TheMahaanOne/inflatable-wing-uav/docs/flowchart.png

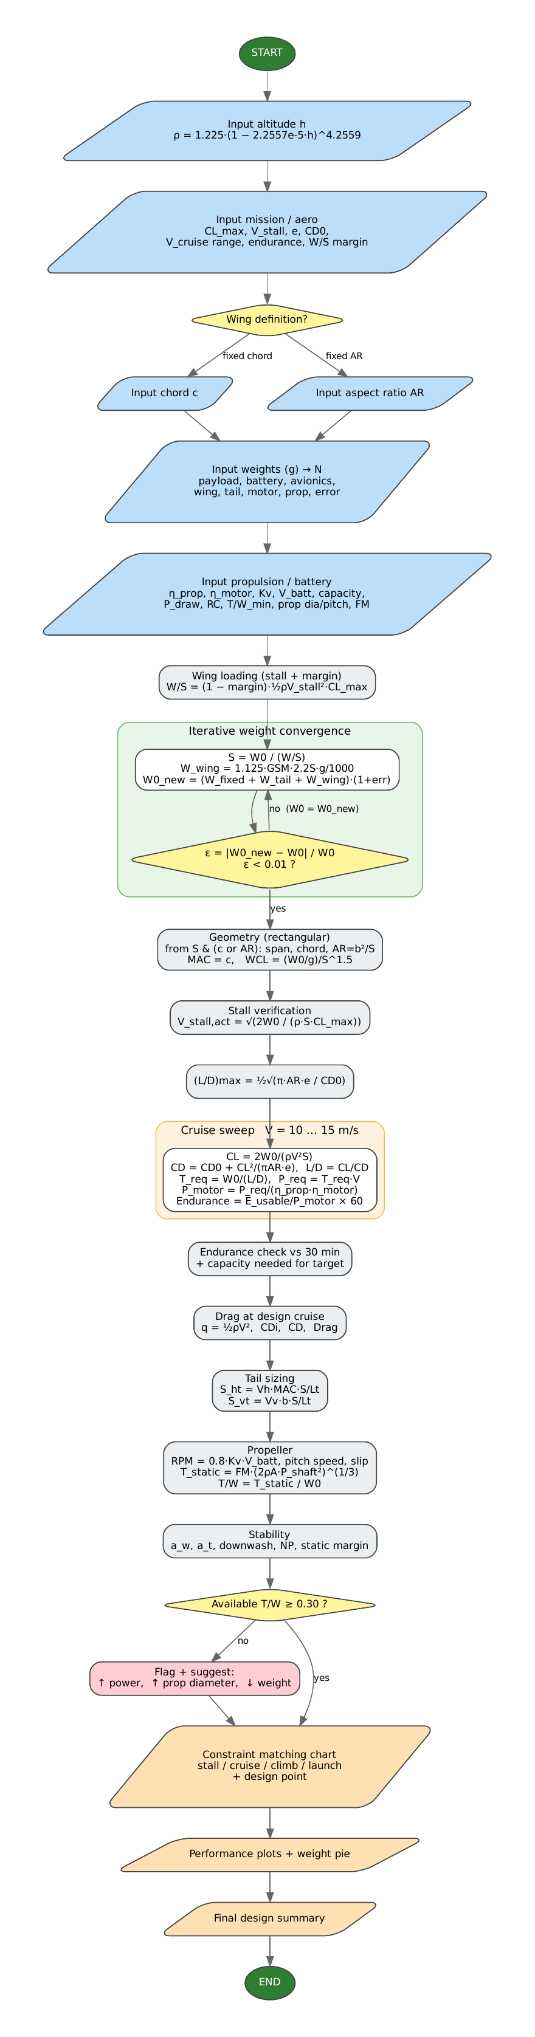
docs/flowchart.png
