TheMahaanOne/inflatable-wing-uav/cad/itr1/uav_itr1.stl

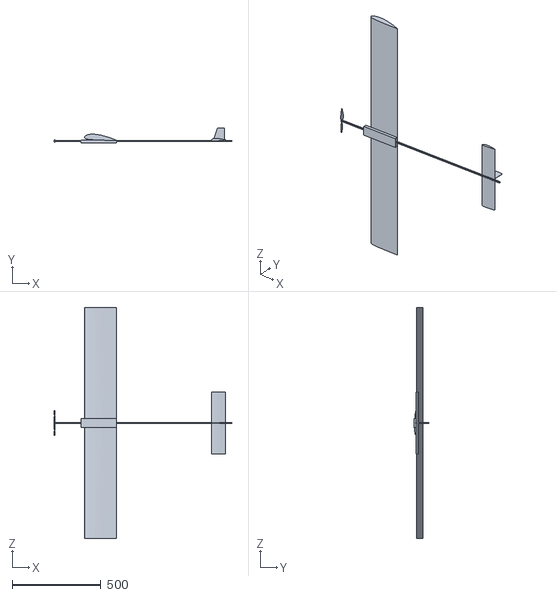
[picture p20: CAD file, 2026-10-17]
cad/itr1/uav_itr1.stl
1000.5 x 85.8 x 1300.0
