TheMahaanOne/inflatable-wing-uav/cad/itr2/uav_itr2.stl

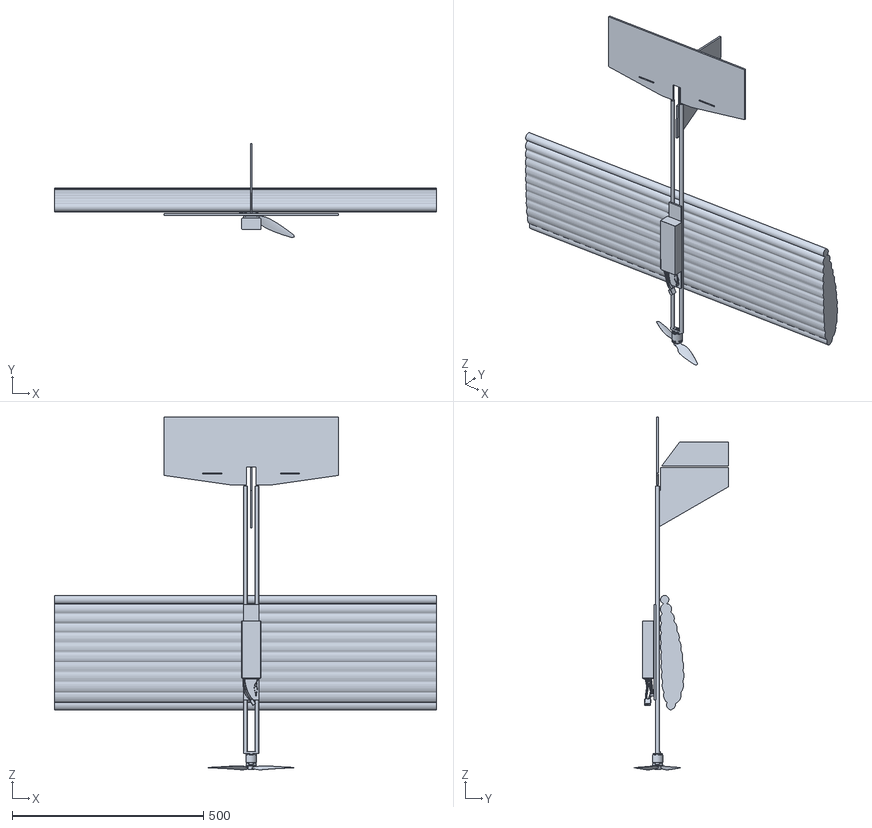
[picture p21: CAD file, 2026-10-17]
cad/itr2/uav_itr2.stl
1000.0 x 246.5 x 923.2
