TheMahaanOne/inflatable-wing-uav/cad/itr3_current/parts/motor_mount_v10.stl

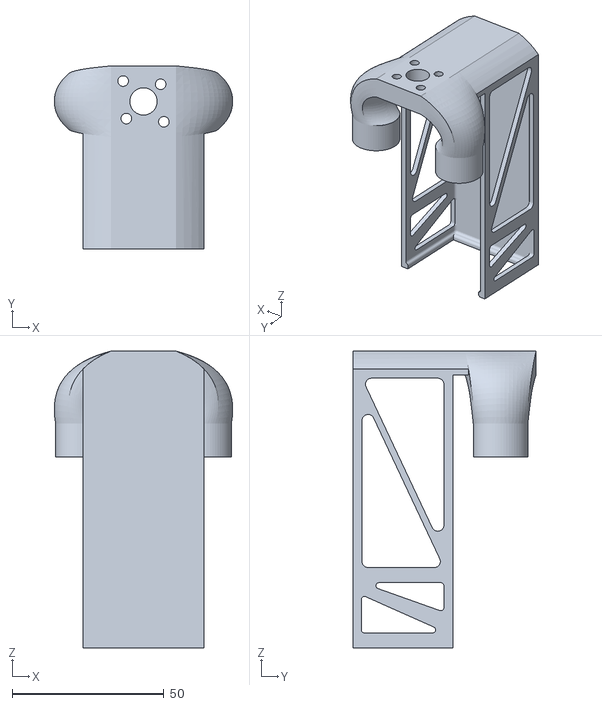
[picture p22: CAD file, 2026-10-17]
cad/itr3_current/parts/motor_mount_v10.stl
58.9 x 60.4 x 98.0
