TheMahaanOne/inflatable-wing-uav/cad/itr3_current/uav_itr3.stl

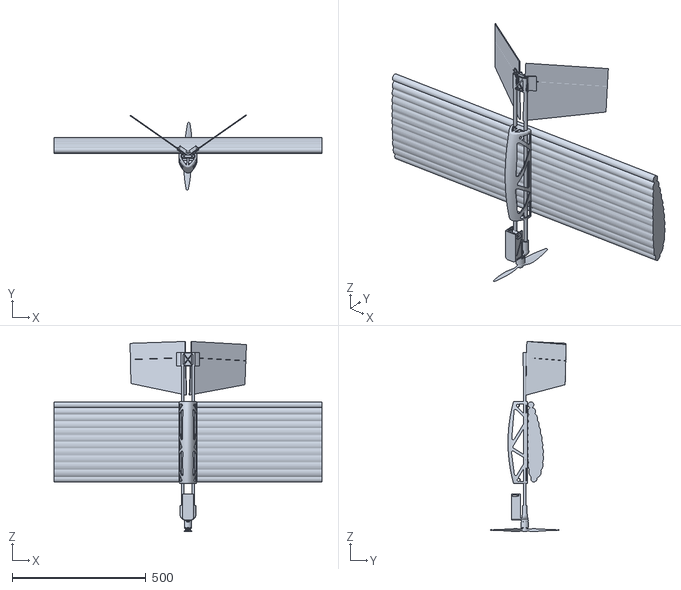
[picture p23: CAD file, 2026-10-17]
cad/itr3_current/uav_itr3.stl
1000.0 x 281.5 x 709.3
