TheMahaanOne/inflatable-wing-uav/cad/itr3_current/parts/v_tail.stl

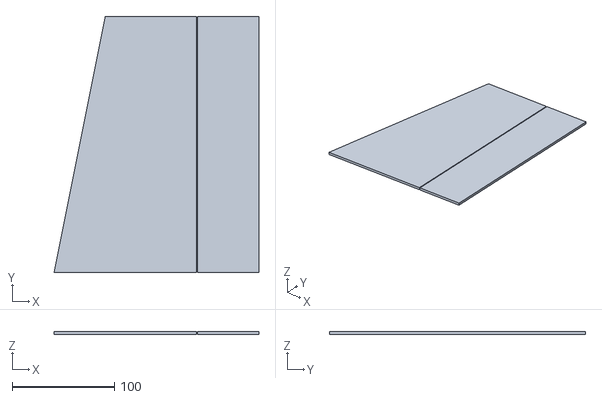
[picture p24: CAD file, 2026-10-17]
cad/itr3_current/parts/v_tail.stl
200.0 x 250.0 x 3.00
