TheMahaanOne/inflatable-wing-uav/cad/itr3_current/parts/v_tail_mount.stl

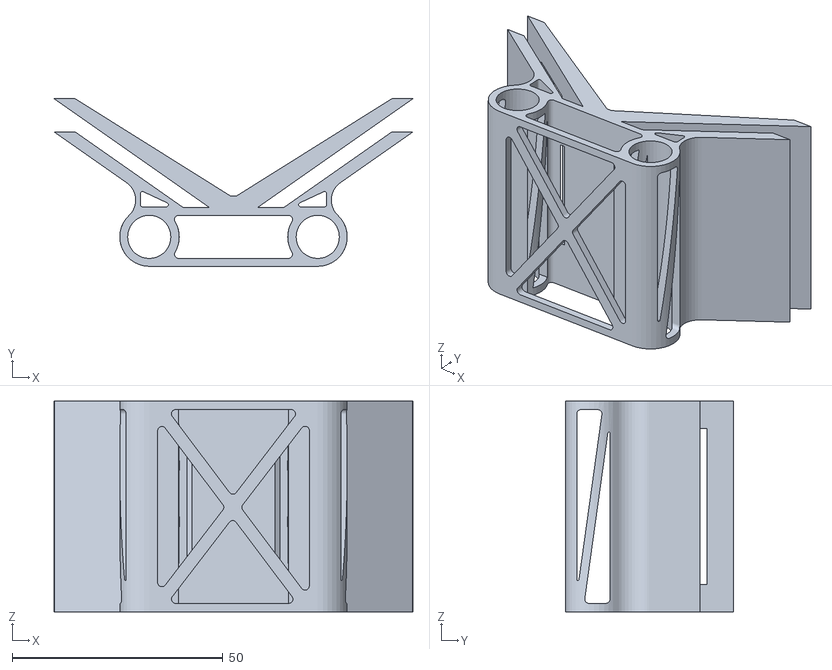
[picture p25: CAD file, 2026-10-17]
cad/itr3_current/parts/v_tail_mount.stl
85.2 x 39.8 x 50.0
