TheMahaanOne/inflatable-wing-uav/cad/itr3_current/parts/hull_v2.stl

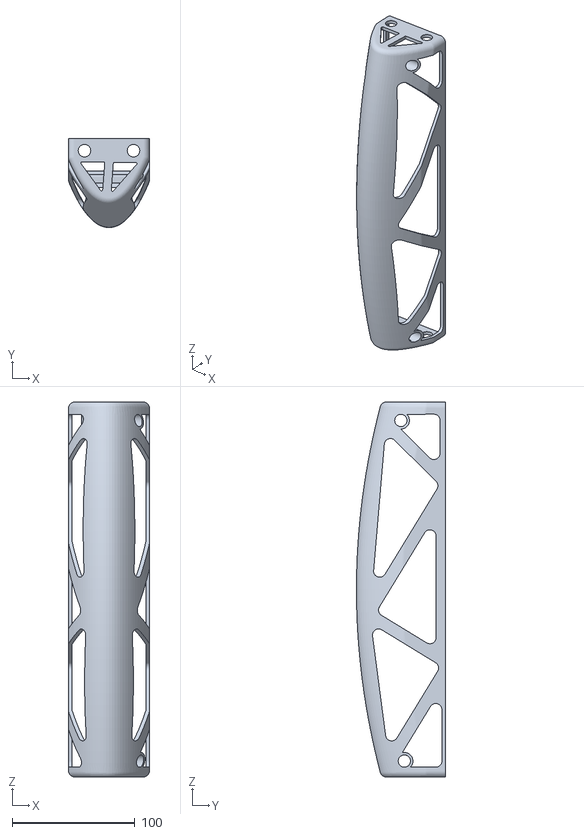
[picture p26: CAD file, 2026-10-17]
cad/itr3_current/parts/hull_v2.stl
66.0 x 72.7 x 306.0
