TheMahaanOne/inflatable-wing-uav/cad/itr3_current/parts/shareer_v3.stl

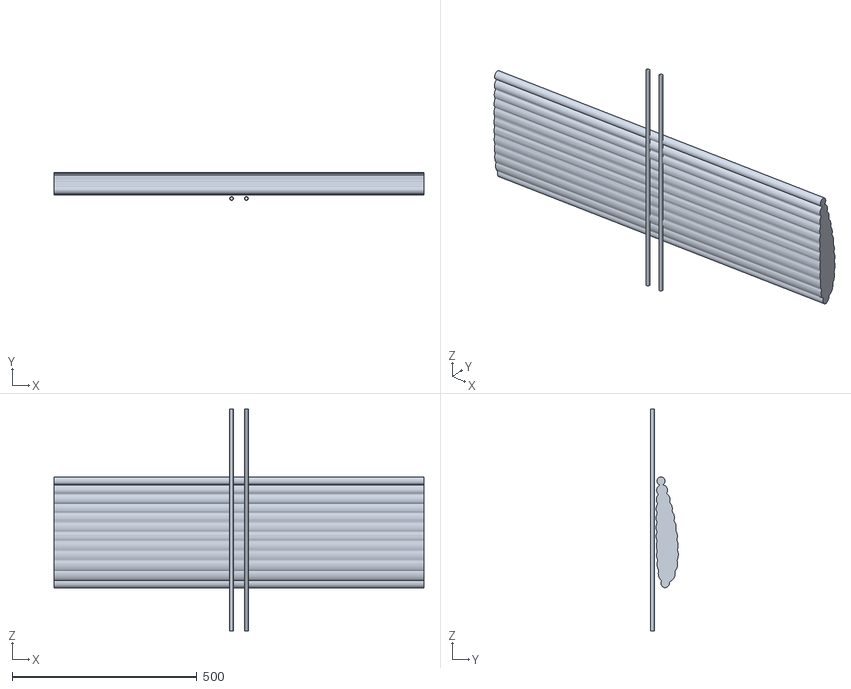
[picture p27: CAD file, 2026-10-17]
cad/itr3_current/parts/shareer_v3.stl
1000.0 x 75.0 x 600.0
