TheMahaanOne/inflatable-wing-uav/cad/itr3_current/parts/battery.stl

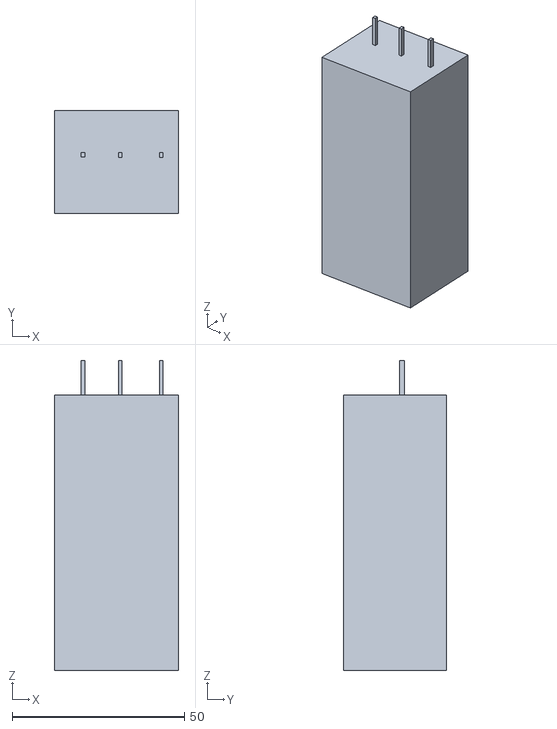
[picture p28: CAD file, 2026-10-17]
cad/itr3_current/parts/battery.stl
36.0 x 30.0 x 90.0
