TheMahaanOne/inflatable-wing-uav/(list of files, cad)

Other CAD files:
cad/itr1/uav_itr1.x_t
cad/itr2/uav_itr2.x_t
cad/itr3_current/parts/battery.x_t
cad/itr3_current/parts/hull_v2.x_t
cad/itr3_current/parts/motor_mount_v10.x_t
cad/itr3_current/parts/shareer_v3.x_t
cad/itr3_current/parts/v_tail.x_t
cad/itr3_current/parts/v_tail_mount.x_t
cad/itr3_current/uav_itr3.x_t
